LeBaggett/PROJETO-TOPICOS-II/documentação/assets/Annotation 2026-01-17 185126.png

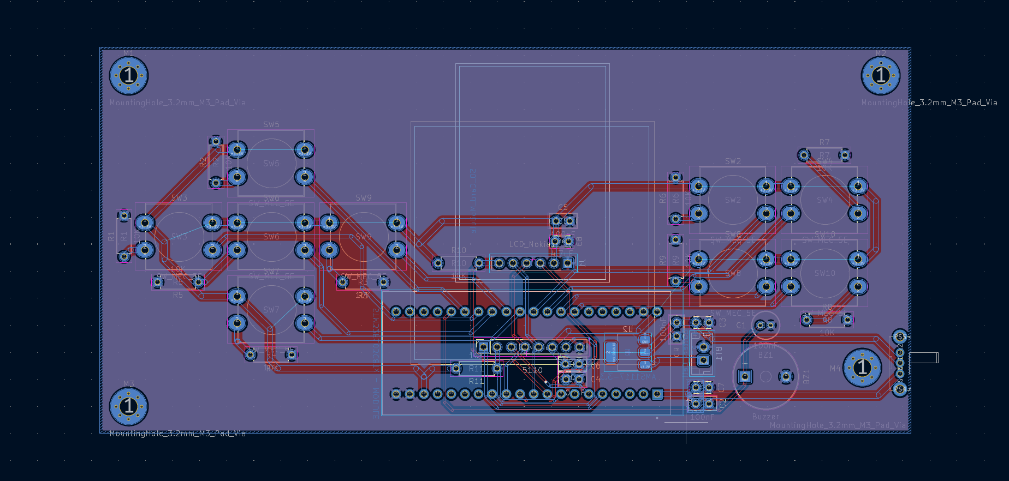
documentação/assets/Annotation 2026-01-17 185126.png
