LeBaggett/PROJETO-TOPICOS-II/documentação/assets/ProtoGame.jpg

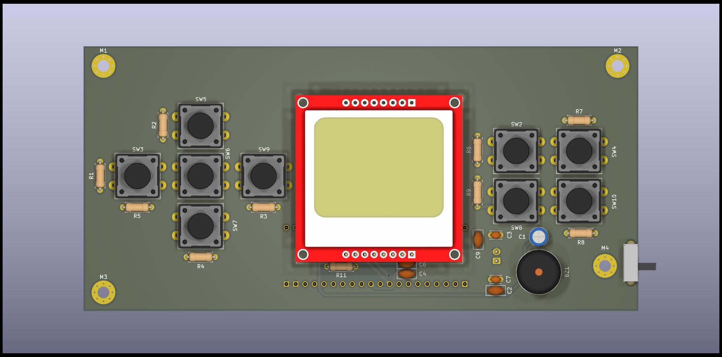
documentação/assets/ProtoGame.jpg
