LeBaggett/PROJETO-TOPICOS-II/documentação/assets/ProtoGame.png

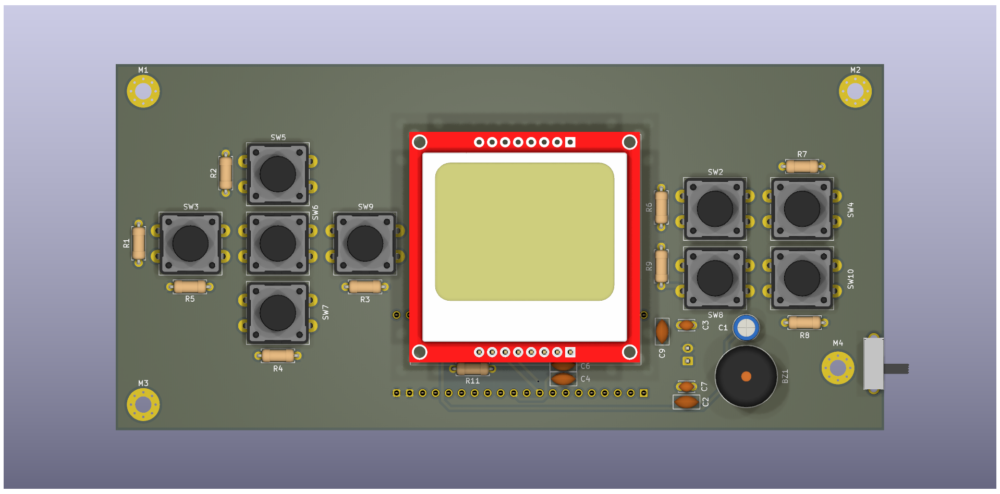
documentação/assets/ProtoGame.png
