LeBaggett/PROJETO-TOPICOS-II/documentação/assets/ProtoGameBack.png

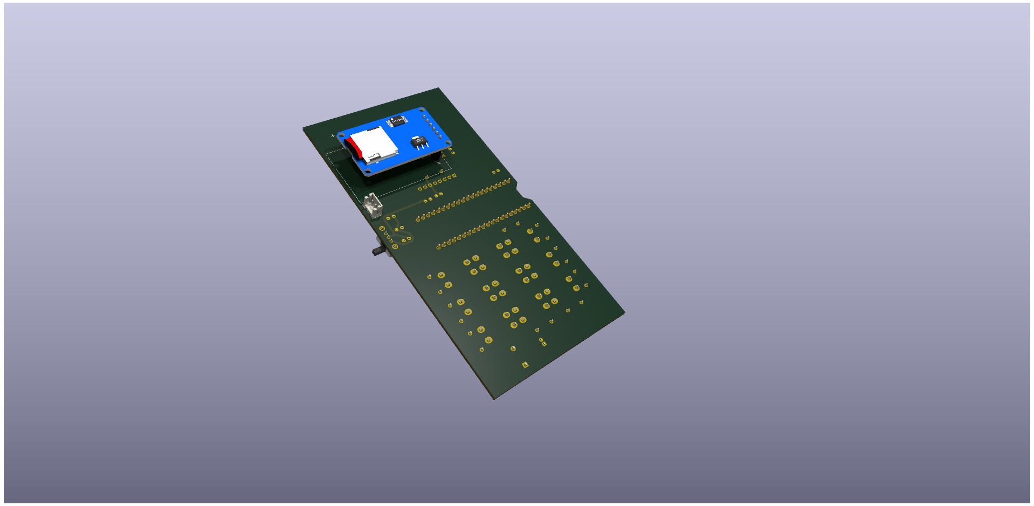
documentação/assets/ProtoGameBack.png
