LeBaggett/PROJETO-TOPICOS-II/documentação/assets/ProtoGameBottom.jpg

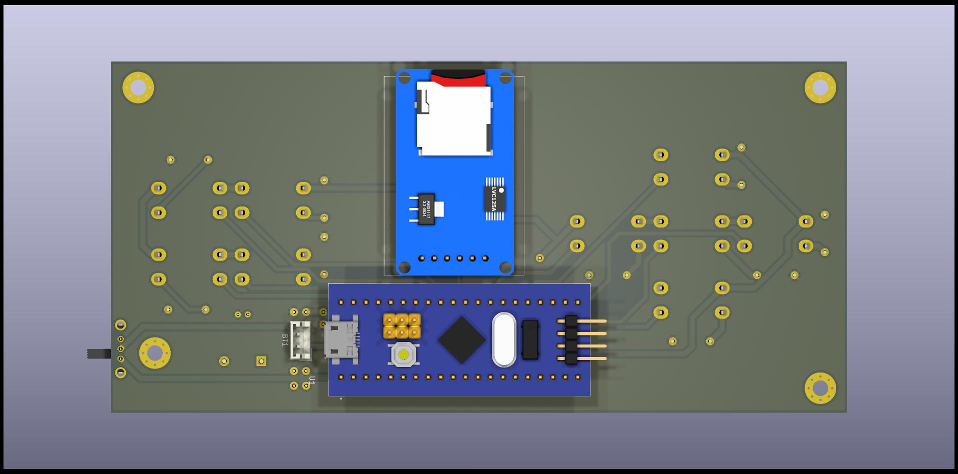
documentação/assets/ProtoGameBottom.jpg
