LeBaggett/PROJETO-TOPICOS-II/documentação/assets/ProtoGameBottom.png

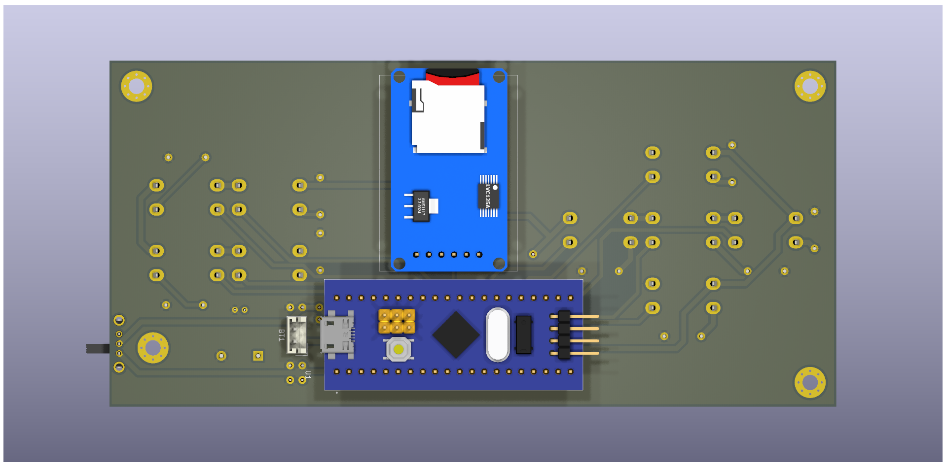
documentação/assets/ProtoGameBottom.png
