LeBaggett/PROJETO-TOPICOS-II/documentação/assets/ProtoGamereal.png

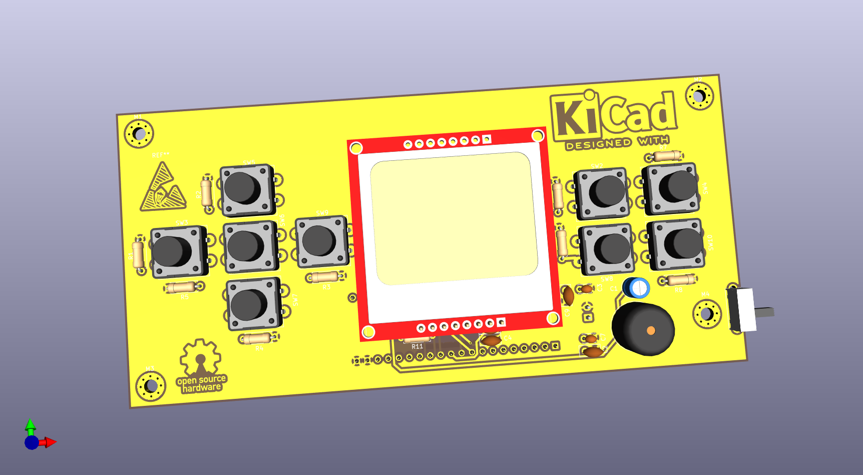
documentação/assets/ProtoGamereal.png
