LeBaggett/PROJETO-TOPICOS-II/documentação/assets/WhatsApp Image 2026-01-23 at 20.32.44.jpeg

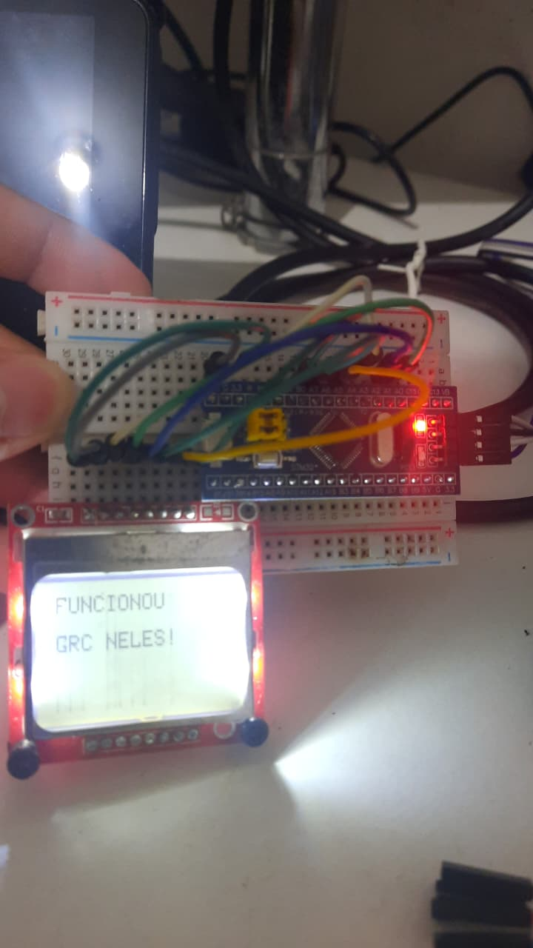
documentação/assets/WhatsApp Image 2026-01-23 at 20.32.44.jpeg
