LeBaggett/PROJETO-TOPICOS-II/hardware/ProtoGame/MicroSD_CARD/MicroSD Reader Assembly.step

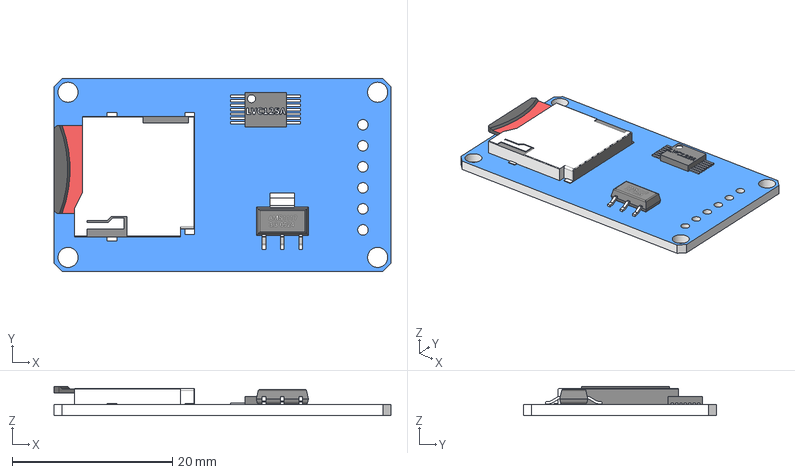
[picture p25: CAD file, 2026-01-24]
hardware/ProtoGame/MicroSD_CARD/MicroSD Reader Assembly.step
42.0 x 24.0 x 3.64 mm
sdreader
AMS1117
card sd
