LeBaggett/PROJETO-TOPICOS-II/hardware/ProtoGame/LCD/Nokia 5110.STEP

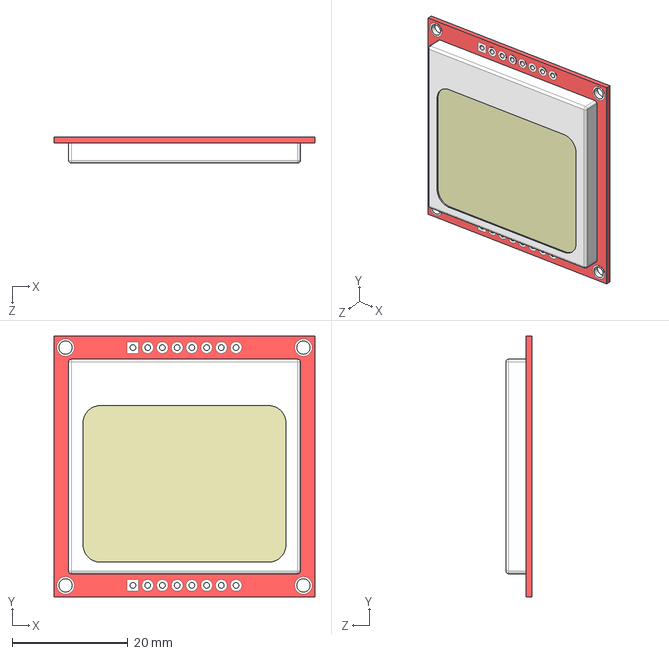
[picture p26: CAD file, 2026-01-24]
hardware/ProtoGame/LCD/Nokia 5110.STEP
45.0 x 45.0 x 4.55 mm
櫻蠉錪1
櫻蠉錪2
