LeBaggett/PROJETO-TOPICOS-II/(list of files, cad)

Other CAD files:
hardware/ProtoGame/MicroSD_CARD/MicroSD Reader Assembly.stp
