LeBaggett/PROJETO-TOPICOS-II/testes/README.md

# testes

Essa pasta contém todos os testes utilizados no projeto.
