LeBaggett/PROJETO-TOPICOS-II/hardware/ProtoGame/ProtoGame-jobset-file/ProtoGame-schematic-v1/ProtoGame.pdf

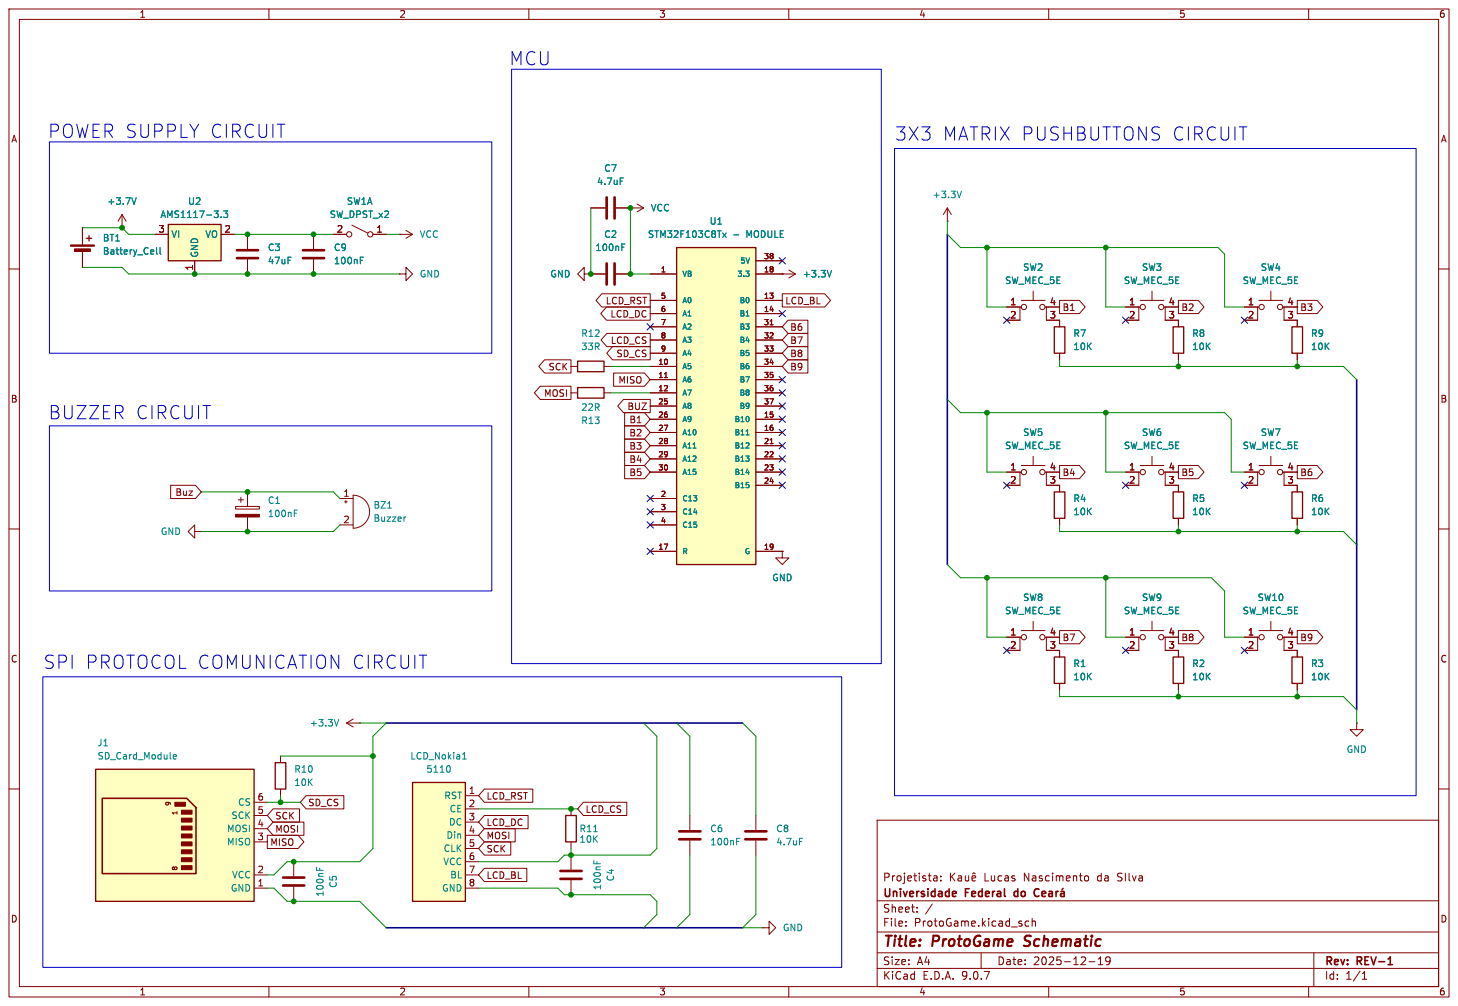
[picture p28: page 1]

3 SW6 SW_MEC_5E RST 1 CE 2 DC 3 Din 4 CLK 5 VCC 6 BL 7 GND 8

SPI PROTOCOL COMUNICATION CIRCUIT

1 8 CS 6 SCK 5 MOSI 4 MISO 3 VCC 2 GND 1

Id: 1/1 Title: ProtoGame Schematic
