LeBaggett/PROJETO-TOPICOS-II/hardware/ProtoGame/ProtoGame-schematic-v1.pdf

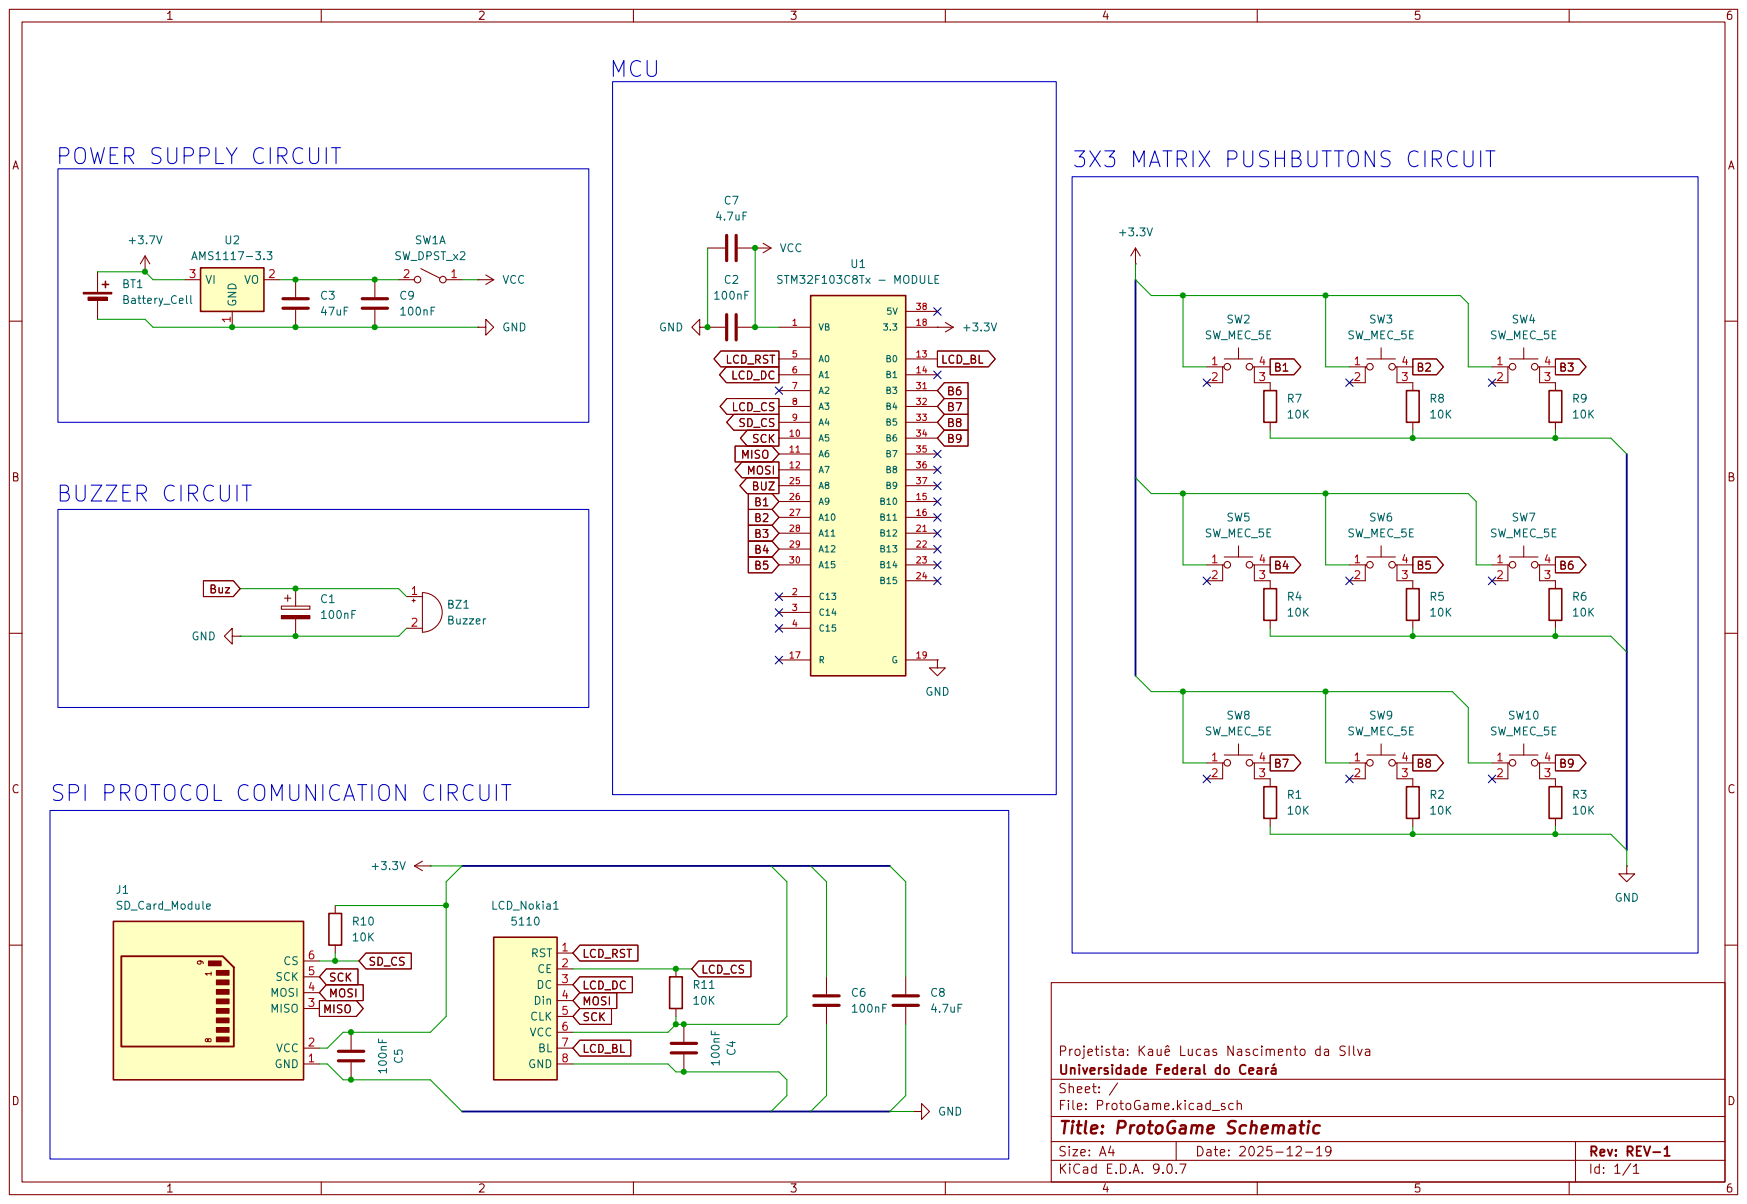
[picture p29: page 1]
