LeBaggett/PROJETO-TOPICOS-II/hardware/ProtoGame/ProtoGame-schematic-v0.pdf

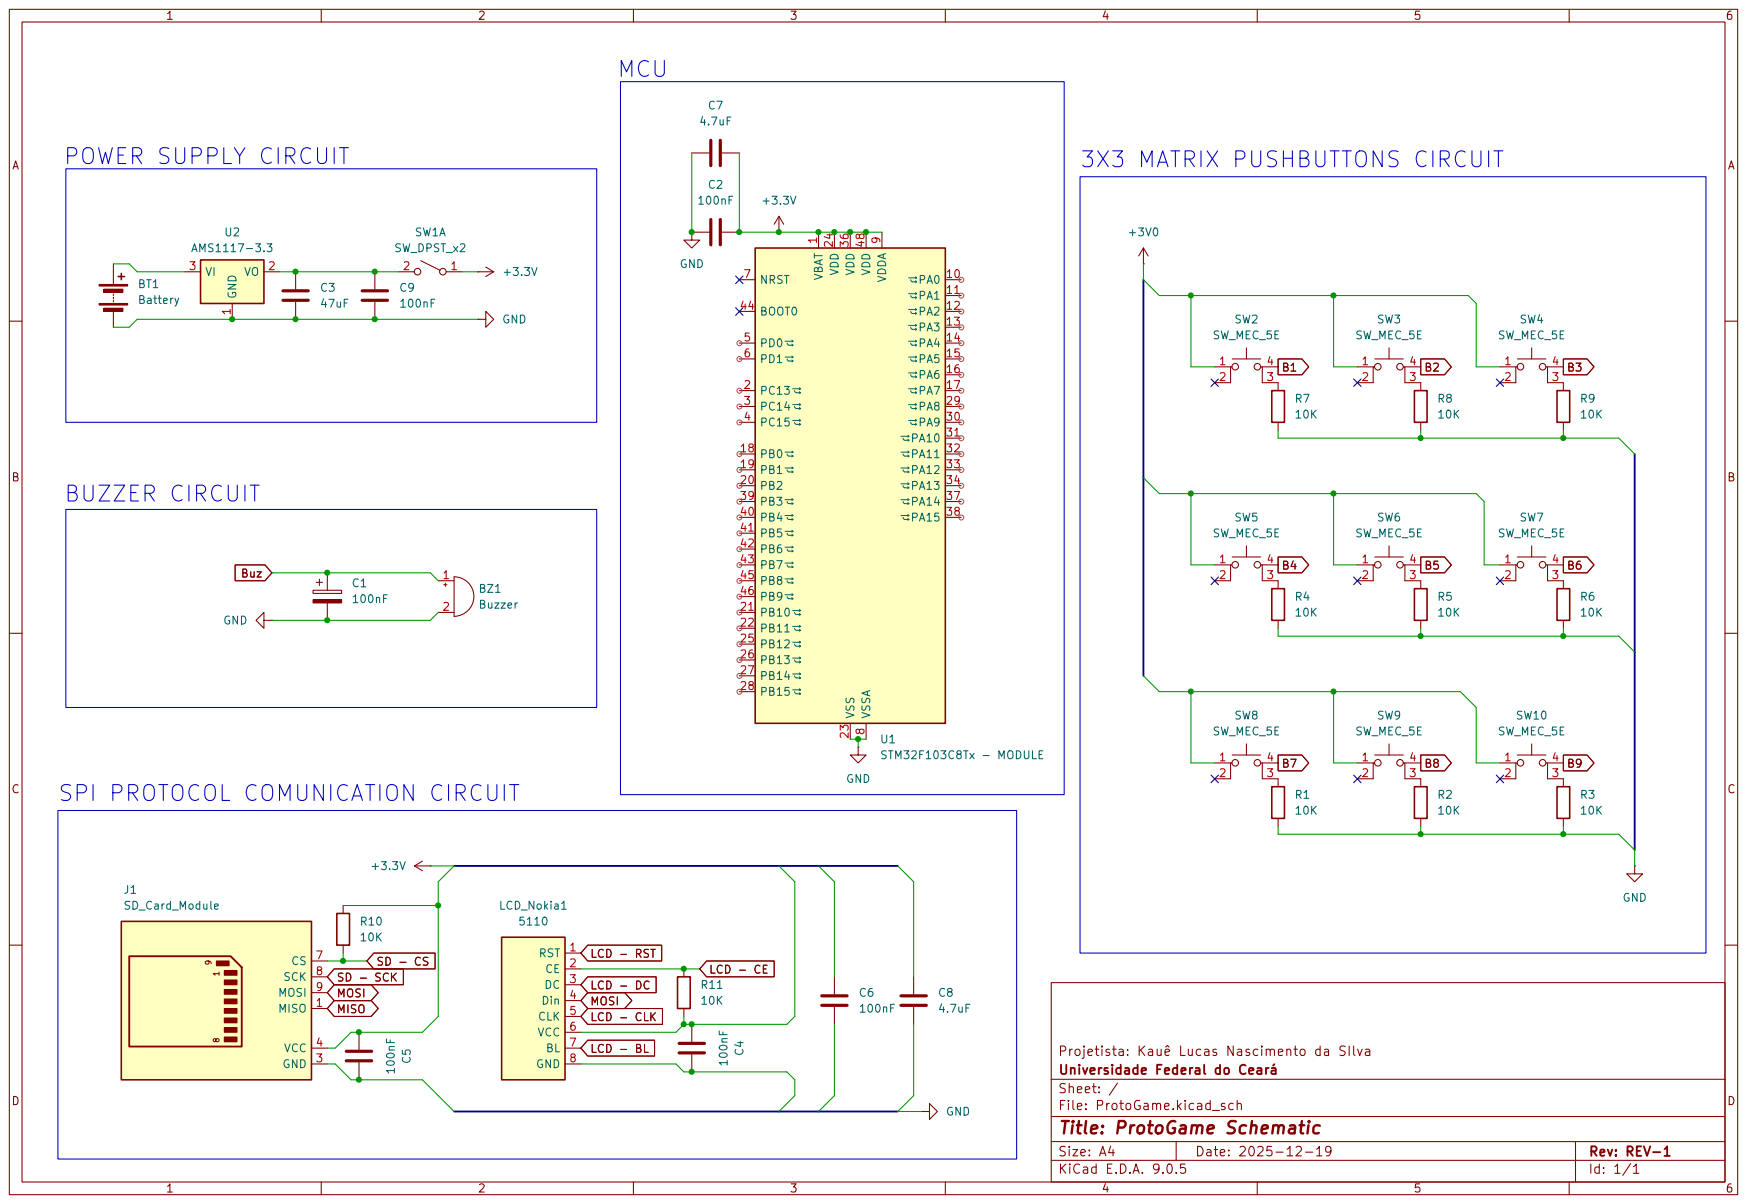
[picture p30: page 1]
