LeBaggett/PROJETO-TOPICOS-II/hardware/ProtoGame/ProtoGame.kicad_pcb

## KiCad design hardware/ProtoGame/ProtoGame.kicad_pcb (2026-01-24)

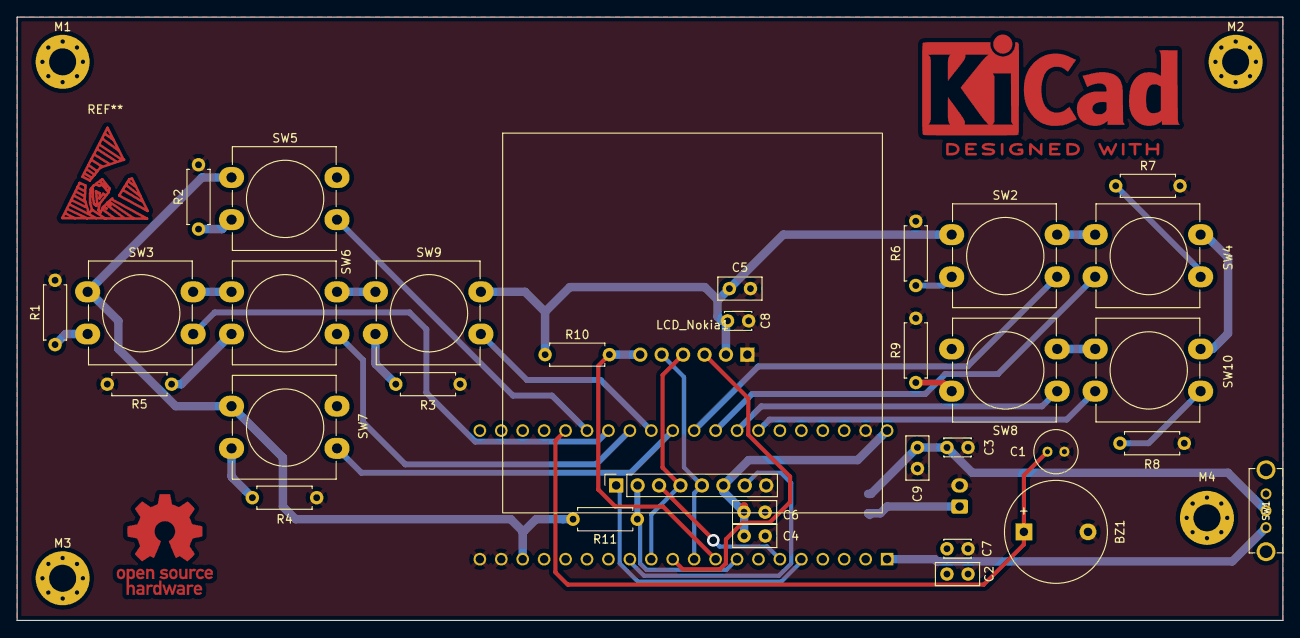
[picture p31: board ProtoGame.kicad_pcb from above]

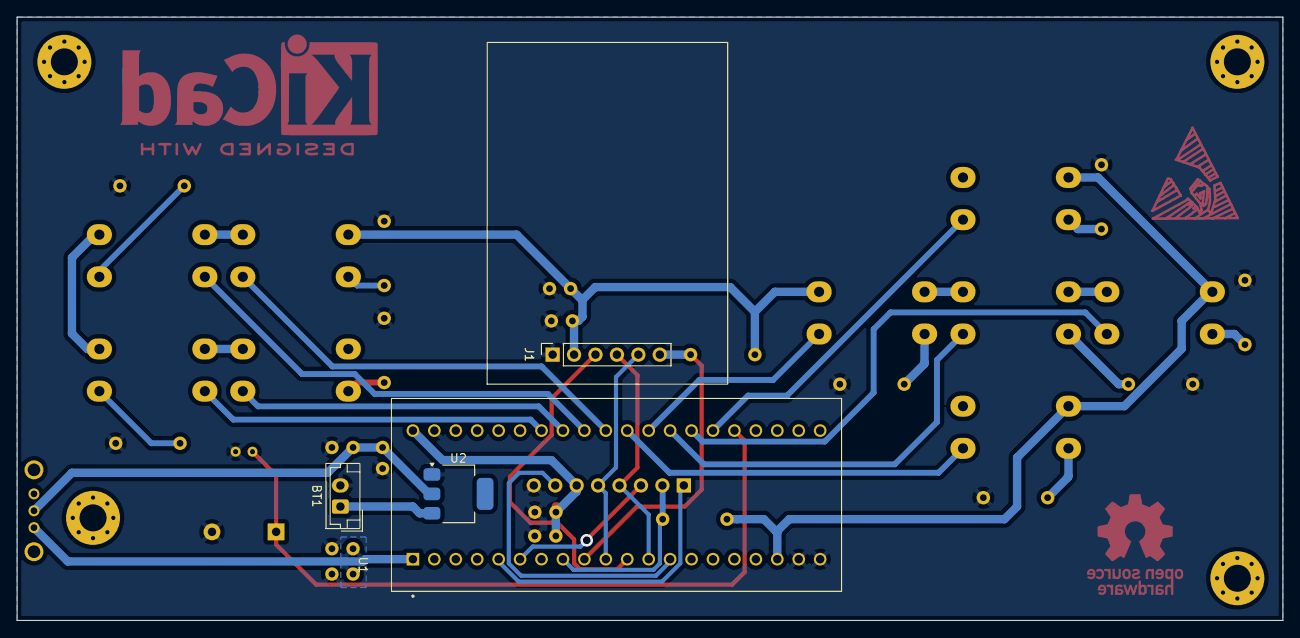
[picture p32: board ProtoGame.kicad_pcb from below]

Board: 2 copper layers, 150.0 x 71.5 mm, 40 parts (4 on the bottom side), 32 nets.

Parts:
BT1: Battery_Cell; JST_EH_B2B-EH-A_1x02_P2.50mm_Vertical
BZ1: Buzzer; Buzzer_12x9.5RM7.6
C1: 100nF; C_Radial_D5.0mm_H5.0mm_P2.00mm
C2, C4, C5, C6, C9: 100nF; C_Disc_D5.0mm_W2.5mm_P2.50mm
C3: 47uF; C_Disc_D3.0mm_W2.0mm_P2.50mm
C7, C8: 4.7uF; C_Disc_D3.0mm_W2.0mm_P2.50mm
J1: SD_Card_Module; microsd_module
LCD_Nokia1: 5110; PinSocket_1x08_P2.54mm_Vertical
M1, M2, M3, M4: MountingHole_3.2mm_M3_Pad_Via
R1, R2, R3, R4, R5, R6, R7, R8, R9, R10, R11: 10K; R_Axial_DIN0207_L6.3mm_D2.5mm_P7.62mm_Horizontal
SW1: SW_DPST_x2; SW_EG1213
SW2, SW3, SW4, SW5, SW6, SW7, SW8, SW9, SW10: SW_MEC_5E; SW_PUSH-12mm_Wuerth-430476085716
U1: STM32F103C8Tx - MODULE; MODULE_ZC323000-with-pinholder
U2: AMS1117-3.3; SOT-223-3_TabPin2

Connections:
+3.3V: C4.1, C5.1, C6.1, C8.1, J1.2 (VCC), LCD_Nokia1.6 (VCC), R10.1, R11.2, SW2.1, SW3.1, SW4.1, SW5.1, SW6.1, SW7.1, SW8.1, SW9.1, SW10.1, U1.18 (3.3), U1.40 (3.3)
+3.7V: BT1.1 (+), U2.3 (VI)
B1: SW5.2, U1.26 (A9)
B2: SW3.2, U1.27 (A10)
B3: SW6.2, U1.28 (A11)
B4: SW9.2, U1.29 (A12)
B5: SW7.2, U1.30 (A15)
B6: SW2.2, U1.31 (B3)
B7: SW4.2, U1.32 (B4)
B8: SW8.2, U1.33 (B5)
B9: SW10.2, U1.34 (B6)
Buz: BZ1.1 (+), C1.1, U1.25 (A8)
GND: BT1.2 (-), BZ1.2 (-), C1.2, C2.2, C3.2, C4.2, C5.2, C6.2, C7.2, C8.2, C9.2, J1.1 (GND), LCD_Nokia1.8 (GND), R1.2, R2.2, R3.2, R4.2, R5.2, R6.2, R7.2, R8.2, R9.2, U1.19 (G), U1.20 (G), U1.39 (G), U2.1 (GND)
LCD_BL: LCD_Nokia1.7 (BL), U1.13 (B0)
LCD_CS: LCD_Nokia1.2 (CE), R11.1, U1.8 (A3)
LCD_DC: LCD_Nokia1.3 (DC), U1.6 (A1)
LCD_RST: LCD_Nokia1.1 (RST), U1.5 (A0)
MISO: J1.3 (MISO), U1.11 (A6)
MOSI: J1.4 (MOSI), LCD_Nokia1.4 (Din), U1.12 (A7)
unnamed: C3.1, C9.1, SW1.2 (B), U2.2 (VO)
unnamed: R7.1, SW4.2
unnamed: R8.1, SW10.2
unnamed: R9.1, SW8.2
unnamed: R4.1, SW7.2
unnamed: R5.1, SW6.2
unnamed: R6.1, SW2.2
unnamed: R1.1, SW3.2
unnamed: R2.1, SW5.2
unnamed: R3.1, SW9.2
SCK: J1.5 (SCK), LCD_Nokia1.5 (CLK), U1.10 (A5)
SD_CS: J1.6 (CS), R10.2, U1.9 (A4)
VCC: C2.1, C7.1, SW1.1 (A), U1.1 (VB)
