LeBaggett/PROJETO-TOPICOS-II/firmware/STM32Clube/Topicos II/Core/Inc/main.h

#define LCD_RST_Pin GPIO_PIN_0
#define LCD_RST_GPIO_Port GPIOA
#define LCD_DC_Pin GPIO_PIN_1
#define LCD_DC_GPIO_Port GPIOA
#define CS_LCD_Pin GPIO_PIN_3
#define CS_LCD_GPIO_Port GPIOA
#define CS_SD_Pin GPIO_PIN_4
#define CS_SD_GPIO_Port GPIOA
#define LCD_BL_Pin GPIO_PIN_0
#define LCD_BL_GPIO_Port GPIOB
#define BUZ_Pin GPIO_PIN_8
#define BUZ_GPIO_Port GPIOA
#define B1_Pin GPIO_PIN_9
#define B1_GPIO_Port GPIOA
#define B2_Pin GPIO_PIN_10
#define B2_GPIO_Port GPIOA
#define B3_Pin GPIO_PIN_11
#define B3_GPIO_Port GPIOA
#define B4_Pin GPIO_PIN_12
#define B4_GPIO_Port GPIOA
#define B5_Pin GPIO_PIN_15
#define B5_GPIO_Port GPIOA
#define B6_Pin GPIO_PIN_3
#define B6_GPIO_Port GPIOB
#define B7_Pin GPIO_PIN_4
#define B7_GPIO_Port GPIOB
#define B8_Pin GPIO_PIN_5
#define B8_GPIO_Port GPIOB
#define B9_Pin GPIO_PIN_6
#define B9_GPIO_Port GPIOB
