LeBaggett/PROJETO-TOPICOS-II/testes/APP/Core/Inc/screen_main_menu.h

/*
 * screen_main_menu.h
 *
 *  Created on: Jan 23, 2026
 *      Author: Kaue Lucas
 */

#ifndef INC_SCREEN_MAIN_MENU_H_
#define INC_SCREEN_MAIN_MENU_H_

#include "screen.h"

extern Screen_t Screen_MainMenu;

#endif /* INC_SCREEN_MAIN_MENU_H_ */
