LeBaggett/PROJETO-TOPICOS-II/firmware/STM32Clube/Topicos II/Core/Drivers/lcd.c

/*
 * lcd.c
 *
 *  Created on: Jan 8, 2026
 *      Author: Ivo Samuel
 */
#include "lcd.h"

// Referência ao SPI configurado no main.c
extern SPI_HandleTypeDef hspi1;

// Tabela de fontes 5x7 (ASCII de 32 a 126)
static const uint8_t ASCII[][5] = {
    {0x00, 0x00, 0x00, 0x00, 0x00}, // (espaço)
    {0x00, 0x00, 0x5f, 0x00, 0x00}, // !
    {0x00, 0x07, 0x00, 0x07, 0x00}, // "
    {0x14, 0x7f, 0x14, 0x7f, 0x14}, // #
    {0x24, 0x2a, 0x7f, 0x2a, 0x12}, // $
    {0x23, 0x13, 0x08, 0x64, 0x62}, // %
    {0x36, 0x49, 0x55, 0x22, 0x50}, // &
    {0x00, 0x05, 0x03, 0x00, 0x00}, // '
    {0x00, 0x1c, 0x22, 0x41, 0x00}, // (
    {0x00, 0x41, 0x22, 0x1c, 0x00}, // )
    {0x14, 0x08, 0x3e, 0x08, 0x14}, // *
    {0x08, 0x08, 0x3e, 0x08, 0x08}, // +
    {0x00, 0x50, 0x30, 0x00, 0x00}, // ,
    {0x08, 0x08, 0x08, 0x08, 0x08}, // -
    {0x00, 0x60, 0x60, 0x00, 0x00}, // .
    {0x20, 0x10, 0x08, 0x04, 0x02}, // /
    {0x3e, 0x51, 0x49, 0x45, 0x3e}, // 0
    {0x00, 0x42, 0x7f, 0x40, 0x00}, // 1
    {0x42, 0x61, 0x51, 0x49, 0x46}, // 2
    {0x21, 0x41, 0x45, 0x4b, 0x31}, // 3
    {0x18, 0x14, 0x12, 0x7f, 0x10}, // 4
    {0x27, 0x45, 0x45, 0x45, 0x39}, // 5
    {0x3c, 0x4a, 0x49, 0x49, 0x30}, // 6
    {0x01, 0x71, 0x09, 0x05, 0x03}, // 7
    {0x36, 0x49, 0x49, 0x49, 0x36}, // 8
    {0x06, 0x49, 0x49, 0x29, 0x1e}, // 9
    {0x00, 0x36, 0x36, 0x00, 0x00}, // :
    {0x00, 0x56, 0x36, 0x00, 0x00}, // ;
    {0x08, 0x14, 0x22, 0x41, 0x00}, // <
    {0x14, 0x14, 0x14, 0x14, 0x14}, // =
    {0x00, 0x41, 0x22, 0x14, 0x08}, // >
    {0x02, 0x01, 0x51, 0x09, 0x06}, // ?
    {0x32, 0x49, 0x79, 0x41, 0x3e}, // @
    {0x7e, 0x11, 0x11, 0x11, 0x7e}, // A
    {0x7f, 0x49, 0x49, 0x49, 0x36}, // B
    {0x3e, 0x41, 0x41, 0x41, 0x22}, // C
    {0x7f, 0x41, 0x41, 0x22, 0x1c}, // D
    {0x7f, 0x49, 0x49, 0x49, 0x41}, // E
    {0x7f, 0x09, 0x09, 0x09, 0x01}, // F
    {0x3e, 0x41, 0x49, 0x49, 0x7a}, // G
    {0x7f, 0x08, 0x08, 0x08, 0x7f}, // H
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
};

// Envia dados ou comandos via SPI
void LCD_Write(uint8_t data, uint8_t mode) {
    HAL_GPIO_WritePin(LCD_DC_GPIO_Port, LCD_DC_Pin, mode);
    HAL_GPIO_WritePin(LCD_CE_GPIO_Port, LCD_CE_Pin, GPIO_PIN_RESET);
    HAL_SPI_Transmit(&hspi1, &data, 1, HAL_MAX_DELAY);
    HAL_GPIO_WritePin(LCD_CE_GPIO_Port, LCD_CE_Pin, GPIO_PIN_SET);
}

// Inicializa o Nokia 5110
void LCD_Init(void) {
    // Reset de Hardware
    HAL_GPIO_WritePin(LCD_RST_GPIO_Port, LCD_RST_Pin, GPIO_PIN_RESET);
    HAL_Delay(10);
    HAL_GPIO_WritePin(LCD_RST_GPIO_Port, LCD_RST_Pin, GPIO_PIN_SET);

    // Ativa a luz de fundo (Pino PB0)
    HAL_GPIO_WritePin(LCD_BL_GPIO_Port, LCD_BL_Pin, GPIO_PIN_SET);

    // Configuração do controlador PCD8544
    LCD_Write(0x21, 0); // Comandos estendidos
    LCD_Write(0xB1, 0); // Contraste VOP
    LCD_Write(0x04, 0); // Coeficiente de temperatura
    LCD_Write(0x14, 0); // Bias 1:48
    LCD_Write(0x20, 0); // Comandos básicos
    LCD_Write(0x0C, 0); // Display normal
}

// Limpa a tela
void LCD_Clear(void) {
    for (int i = 0; i < 504; i++) {
        LCD_Write(0x00, 1);
    }
}

// Posiciona o cursor
void LCD_SetCursor(uint8_t x, uint8_t y) {
    if (x > 83) x = 83;
    if (y > 5) y = 5;
    LCD_Write(0x80 | x, 0);
    LCD_Write(0x40 | y, 0);
}

// Escreve um caractere
void LCD_WriteChar(char c) {
    if (c < 32 || c > 126) return;
    for (int i = 0; i < 5; i++) {
        LCD_Write(ASCII[c - 32][i], 1);
    }
    LCD_Write(0x00, 1); // Espaço entre letras
}

// Escreve uma string
void LCD_PrintString(char *str) {
    while (*str) {
        LCD_WriteChar(*str++);
    }
}
