LeBaggett/PROJETO-TOPICOS-II/testes/APP/Core/Inc/screen_logo.h

/*
 * screen_logo.h
 *
 *  Created on: Jan 23, 2026
 *      Author: Kaue Lucas
 */

#ifndef INC_SCREEN_LOGO_H_
#define INC_SCREEN_LOGO_H_

#include "screen.h"

extern Screen_t Screen_Logo;

#endif /* INC_SCREEN_LOGO_H_ */
