LeBaggett/PROJETO-TOPICOS-II/testes/APP/Core/Inc/ui_menu.h

/*
 * ui_menu.h
 *
 *  Created on: Jan 23, 2026
 *      Author: Kaue Lucas
 */

#ifndef INC_UI_MENU_H_
#define INC_UI_MENU_H_

void Menu_Init(void);
void Menu_Update(void);

#endif /* INC_UI_MENU_H_ */
