LeBaggett/PROJETO-TOPICOS-II/(commit log)

2025-09-21 Criação de README.md
    Criação da pasta de hardware.
2025-09-21 Criação de README.md
    Criação da pasta de firmware.
2025-09-21 Criação de README.md
    Criação da pasta de documentação.
2025-09-21 Criação de README.md
    Criação da pasta de assets.
2025-09-21 Criação de README.md
    Criação da pasta de testes.
2025-12-19 Begin the schematic PCB project
    [ProtoGame.kicad_pcb, ProtoGame.kicad_sch]
2025-12-19 ADD SDCARD MODULE, LCD and Buzzer circuit and Power Supply circuit
    [ProtoGame.kicad_sch]
2025-12-20 ADD a project ProtoGame in STM32F103C8T6 and set pinout
2025-12-20 Update schemmatic
    [ProtoGame.kicad_sch]
2025-12-20 Update schematic
    [ProtoGame.csv, ProtoGame.kicad_sch]
2025-12-26 Add MCU Pinout
    [ProtoGame.kicad_sch]
2025-12-26 Add the footprints and 3D models for ProtoGame PCI and add the png assets v0
    [MicroSD Reader Assembly.step, MicroSD Reader Assembly.stp, Nokia 5110.STEP, ProtoGame.kicad_pcb, ProtoGame.kicad_sch, STM32F103C8T6_Blue_Pill v6.step]
2026-01-17 ProtoGame v2 its complete and with new design, add assets images: footprint and 3d model
    [ProtoGame.kicad_pcb, ProtoGame.kicad_sch]
2026-01-19 Código do STM32
2026-01-19 add 'frufrus' in pcb
    [ProtoGame.kicad_pcb]
2026-01-19 add asset (pcb without mask image)
2026-01-19 Revise README for STM32 portable game documentation
    This update expands the README to include detailed documentation for a portable video game project using the STM32F103C8T6 microcontroller, covering objectives, system overview, component choices, and more.
2026-01-20 add gerber and drill files to manufactoring PCB
    [ProtoGame.kicad_pcb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]
2026-01-20 add assets images and replace vias and tracks in pcb, corrige the tracks and generate the gerber and drill files and generate the schematic pdf and generate the pcb in 3d and generatee the BoM
    [ProtoGame.kicad_pcb, ProtoGamev1.csv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]
2026-01-21 little bit refactor in schematic
    [ProtoGame.kicad_sch]
2026-01-21 Add jobset files
    [ProtoGame-B_Cu.gbl, ProtoGame-Edge_Cuts.gm1, ProtoGame-F_Cu.gtl, ProtoGame-job.gbrjob, ProtoGame.drl]
2026-01-21 Revise HARDWARE.md with new schematic links and images
    Updated schematic references and added PCB layer images.
2026-01-24 Expand documentation for STM32F103xx microcontrollers and fineshed
    Add detailed overview and features of STM32F103xx family.
