LeBaggett/PROJETO-TOPICOS-II/(notices)

Notices in the files:
firmware/STM32Clube/Topicos II/Core/Inc/main.h:
Copyright (c) 2026 STMicroelectronics.
All rights reserved.
This software is licensed under terms that can be found in the LICENSE file
